Clemente-Alvarez/arduino-termostat/docs/termostat setup.jpeg

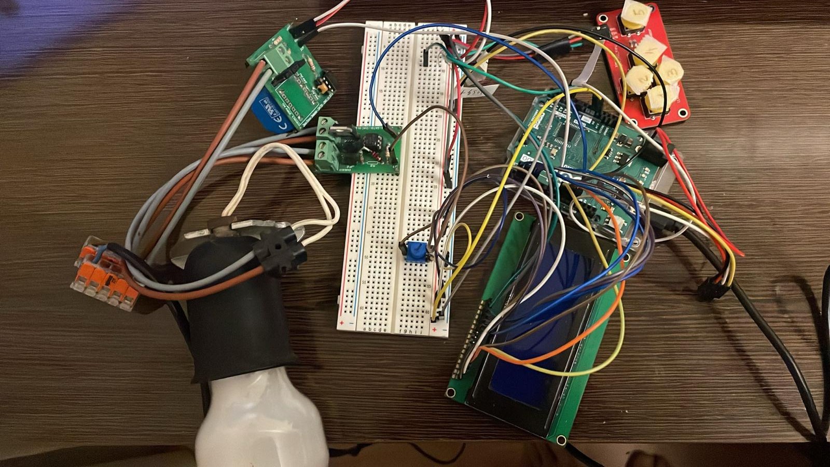
docs/termostat setup.jpeg
