Clemente-Alvarez/arduino-termostat/sensors.h

#define SENSOR_TEMPERATURA 5 //A2
#define SENSOR_LUZ 4 //A3

#define MAX_TEMPERATURE 50
#define MIN_TEMPERATURE -15

#define MAX_LIGHT 1023
#define MIN_LIGHT 0

int getBrightness();

float getTemperature();
